JoshSilver8/ENGR454_Buck_Converter/Pictures/buckconvPCB.png

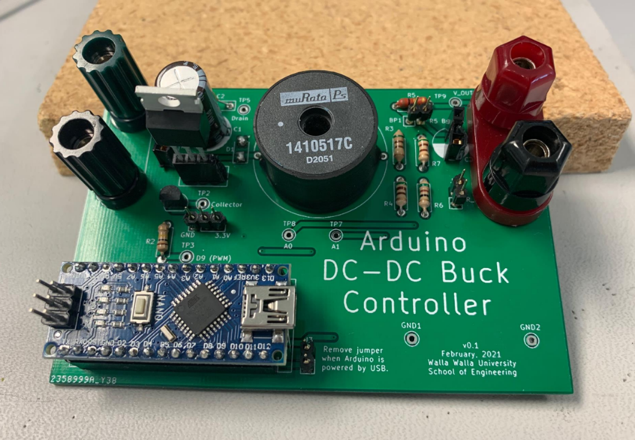
Pictures/buckconvPCB.png
