JoshSilver8/ENGR454_Buck_Converter/Pictures/buckconvPCBback.png

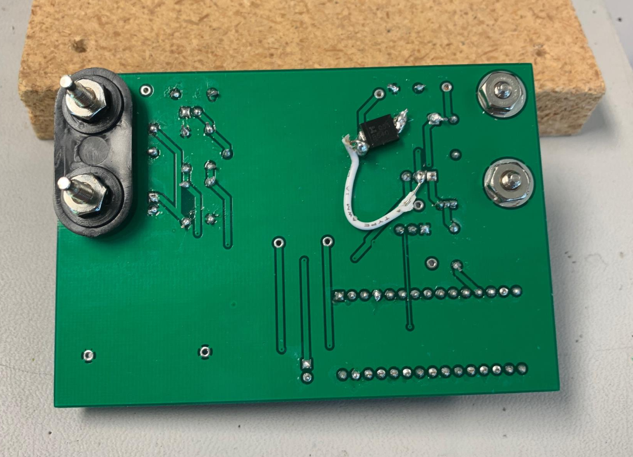
Pictures/buckconvPCBback.png
