JoshSilver8/ENGR454_Buck_Converter/Pictures/BuckConverterTopologyIdeal.png

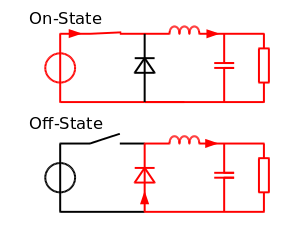
Pictures/BuckConverterTopologyIdeal.png
