JoshSilver8/ENGR454_Buck_Converter/Pictures/DCM_Python.png

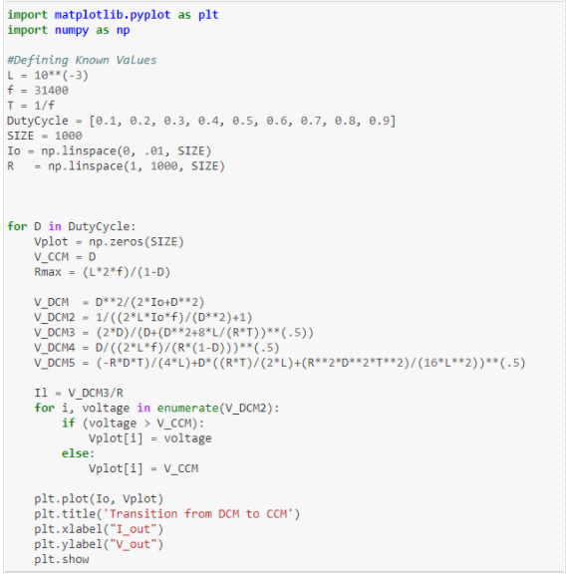
Pictures/DCM_Python.png
