JoshSilver8/ENGR454_Buck_Converter/Pictures/DCM_to_CCM_Graph.png

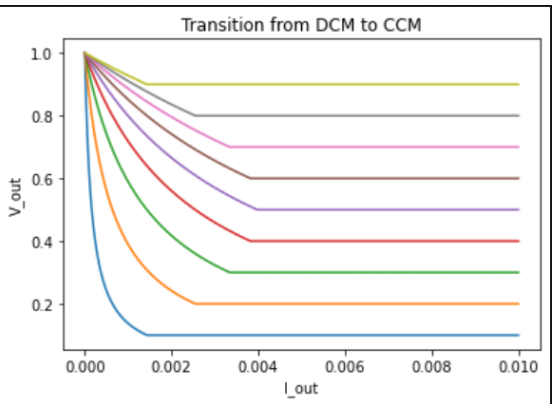
Pictures/DCM_to_CCM_Graph.png
