JoshSilver8/ENGR454_Buck_Converter/Pictures/Feedback_BD.png

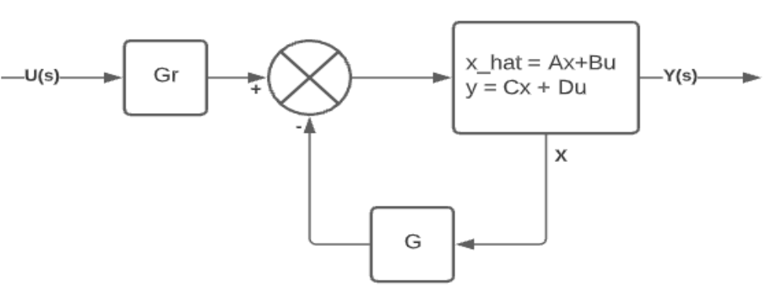
Pictures/Feedback_BD.png
