JoshSilver8/ENGR454_Buck_Converter/Pictures/fullorderobserverarduino.png

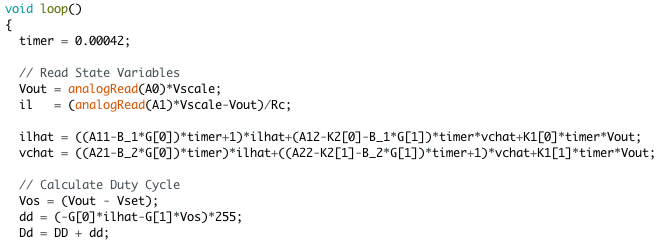
Pictures/fullorderobserverarduino.png
