JoshSilver8/ENGR454_Buck_Converter/Pictures/Fullorderobserverblockdiagram.png

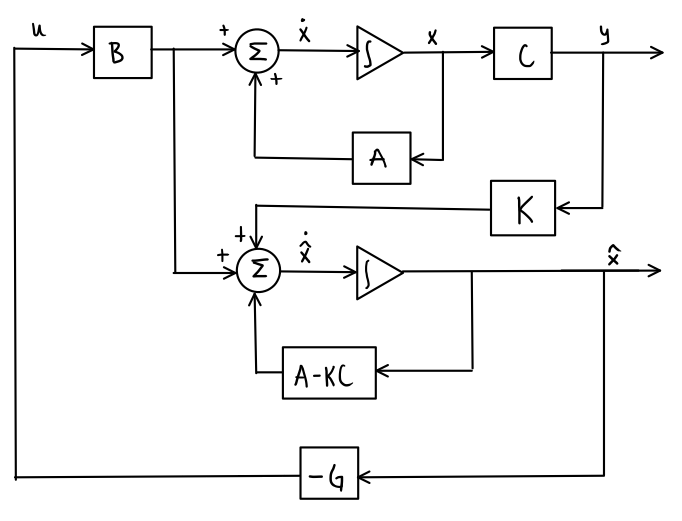
Pictures/Fullorderobserverblockdiagram.png
