JoshSilver8/ENGR454_Buck_Converter/Pictures/fullorderobserverdiscrete1.png

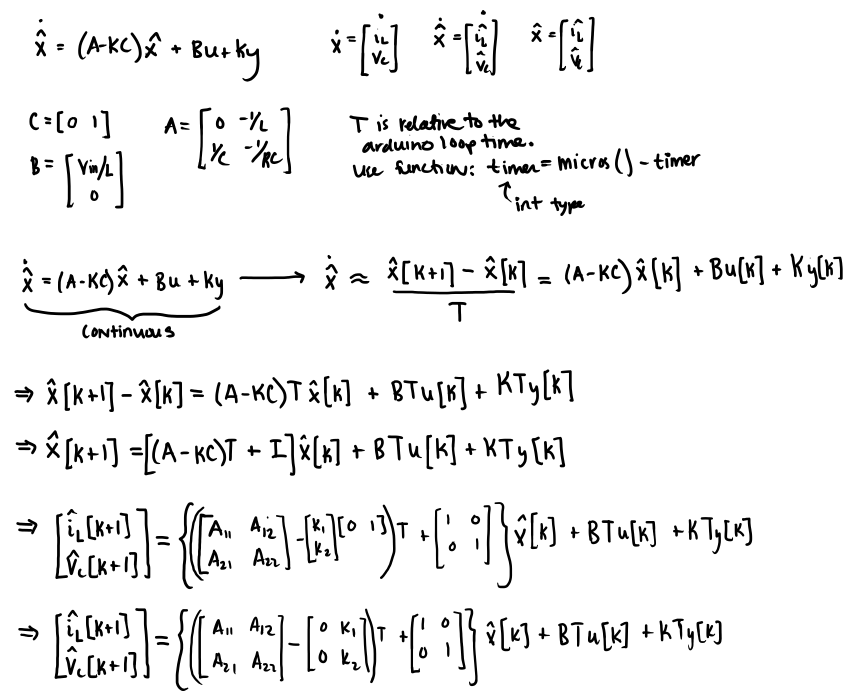
Pictures/fullorderobserverdiscrete1.png
