JoshSilver8/ENGR454_Buck_Converter/Pictures/fullorderobserverdiscrete2.png

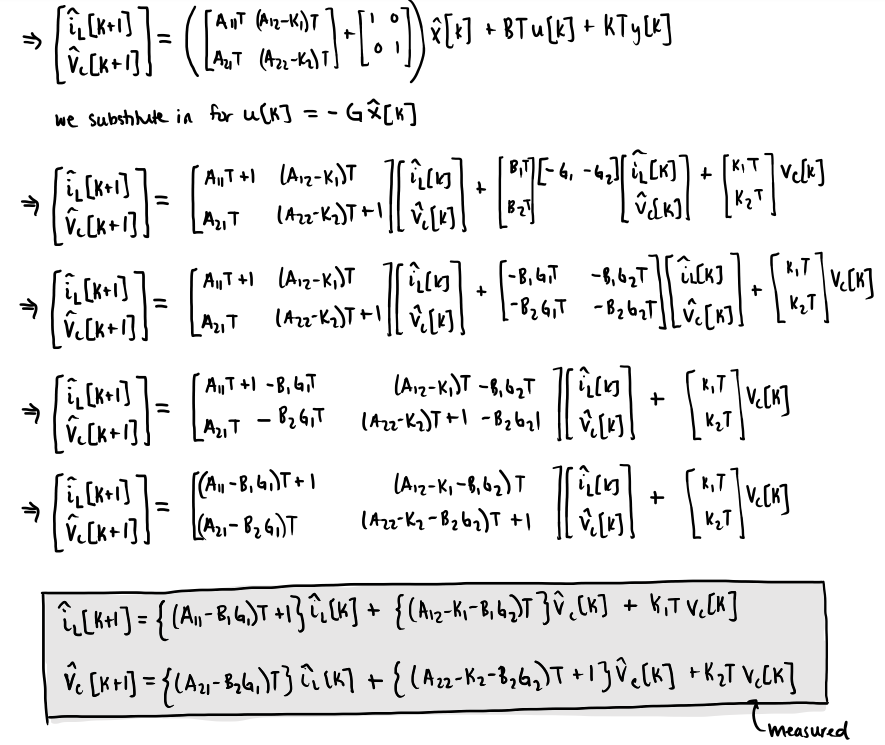
Pictures/fullorderobserverdiscrete2.png
