JoshSilver8/ENGR454_Buck_Converter/Pictures/Fullorderobserveroscilloscope.PNG

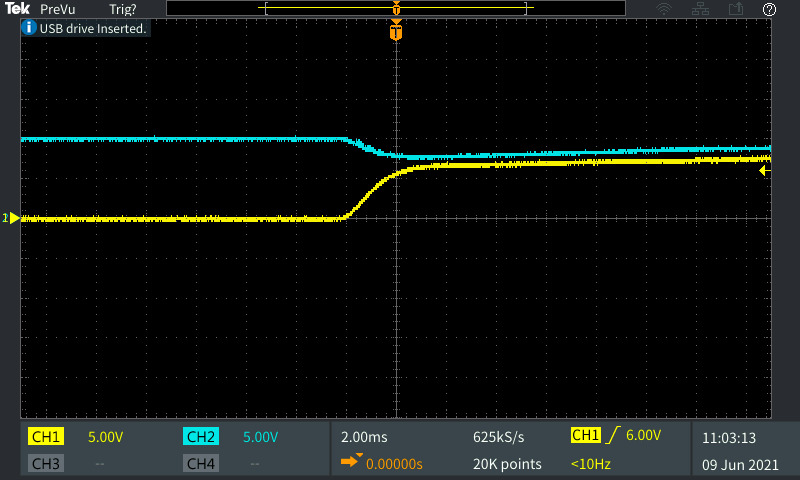
Pictures/Fullorderobserveroscilloscope.PNG
