JoshSilver8/ENGR454_Buck_Converter/Pictures/HPP_eq2.png

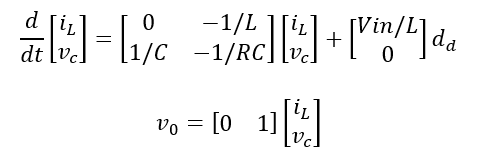
Pictures/HPP_eq2.png
