JoshSilver8/ENGR454_Buck_Converter/Pictures/Pole_Placement_Comp.png

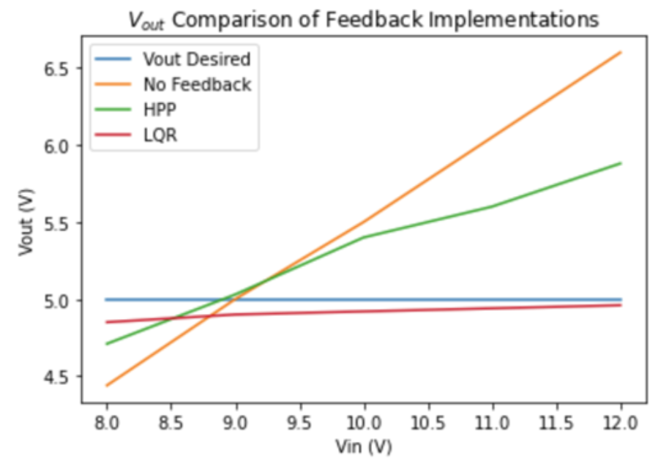
Pictures/Pole_Placement_Comp.png
