JoshSilver8/ENGR454_Buck_Converter/Pictures/reducedorderarduinocode.png

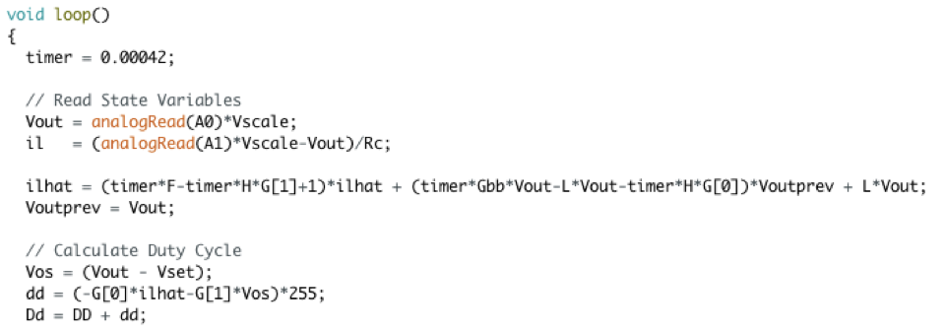
Pictures/reducedorderarduinocode.png
