JoshSilver8/ENGR454_Buck_Converter/Pictures/reducedordercomparison1.png

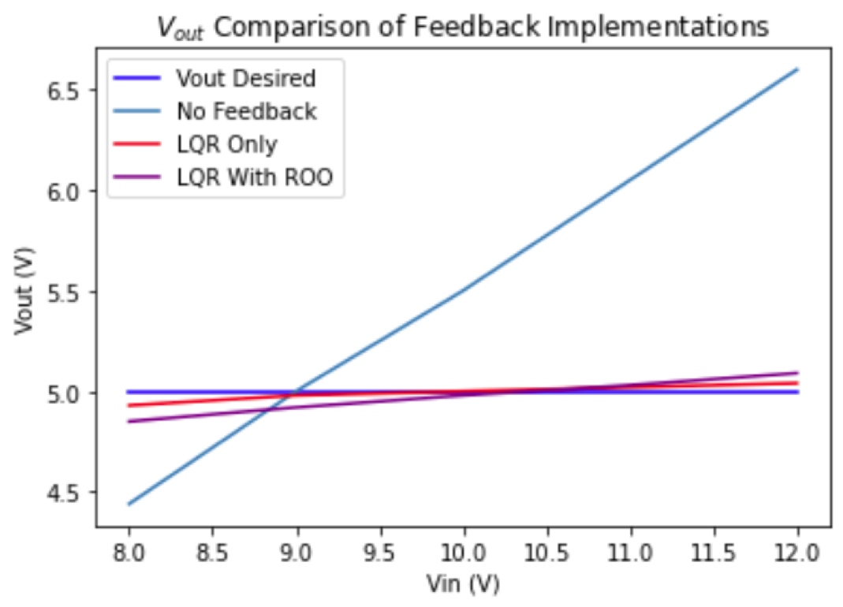
Pictures/reducedordercomparison1.png
