JoshSilver8/ENGR454_Buck_Converter/Pictures/reducedordercomparison2.png

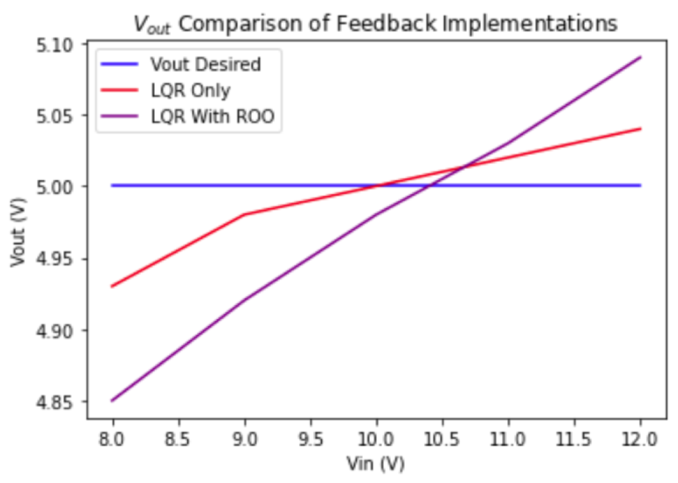
Pictures/reducedordercomparison2.png
