JoshSilver8/ENGR454_Buck_Converter/Pictures/reducedorderdiscretetime.png

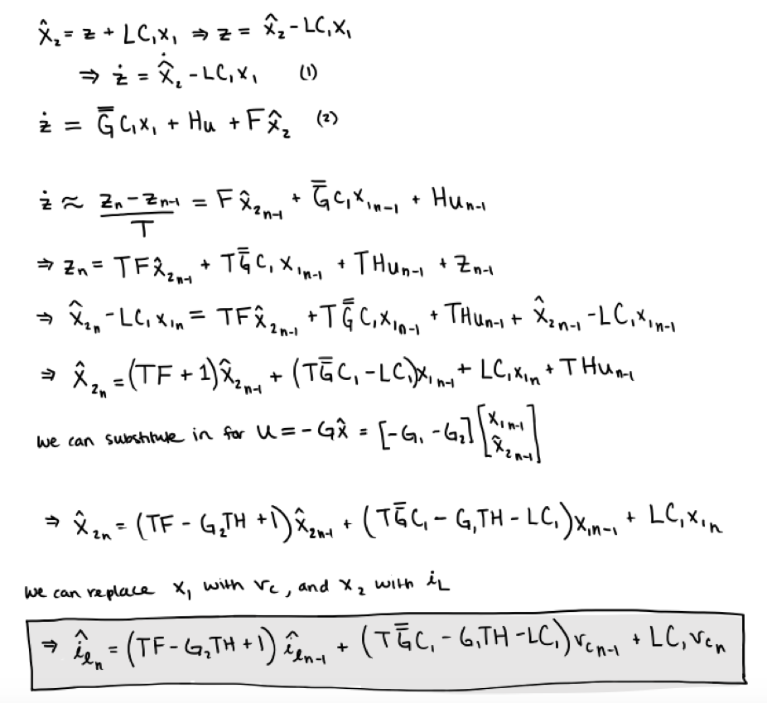
Pictures/reducedorderdiscretetime.png
