JoshSilver8/ENGR454_Buck_Converter/Pictures/reducedorderequations.png

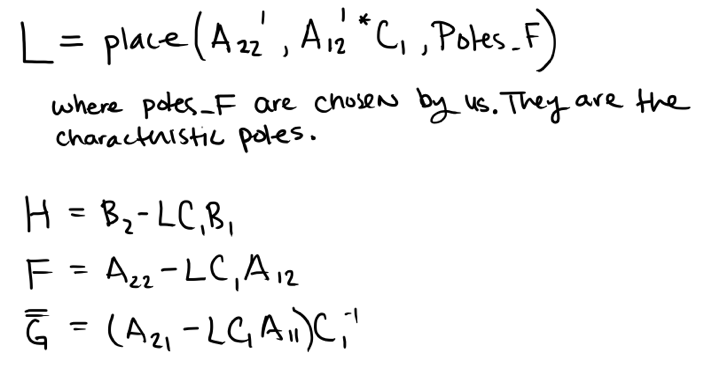
Pictures/reducedorderequations.png
