JoshSilver8/ENGR454_Buck_Converter/Pictures/reducedorderfeedbackvalues.png

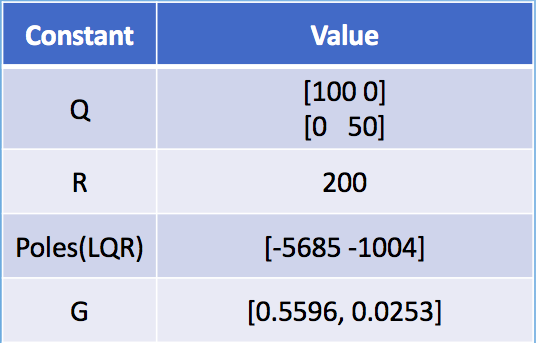
Pictures/reducedorderfeedbackvalues.png
