JoshSilver8/ENGR454_Buck_Converter/Pictures/reducedordermatlaberror.png

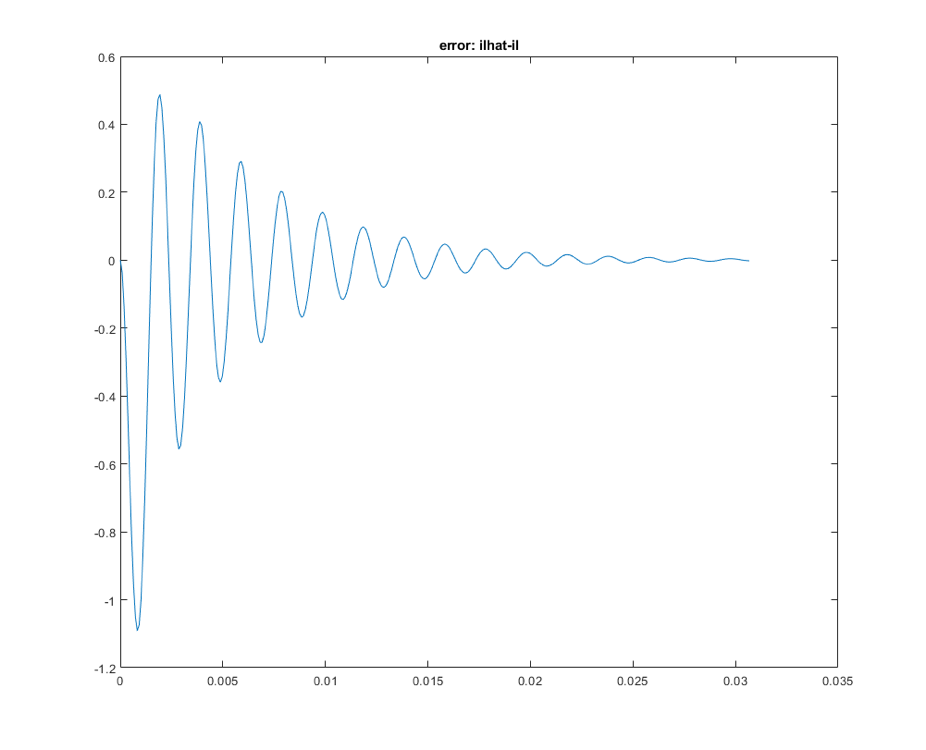
Pictures/reducedordermatlaberror.png
