JoshSilver8/ENGR454_Buck_Converter/Pictures/reducedordermatlabfeedback.png

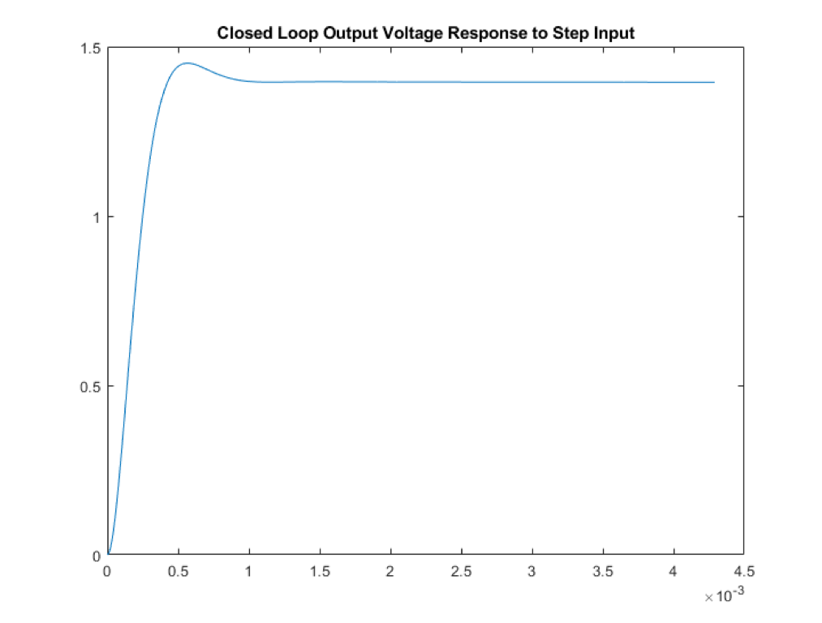
Pictures/reducedordermatlabfeedback.png
