JoshSilver8/ENGR454_Buck_Converter/Pictures/reducedordermatrix.png

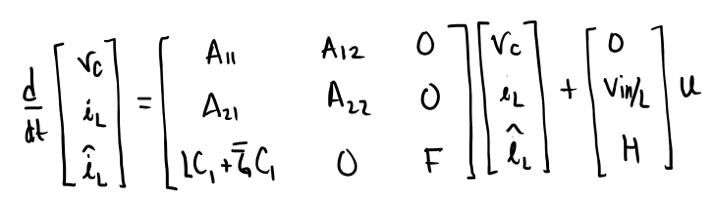
Pictures/reducedordermatrix.png
