JoshSilver8/ENGR454_Buck_Converter/Pictures/reducedorderoscilloscope.png

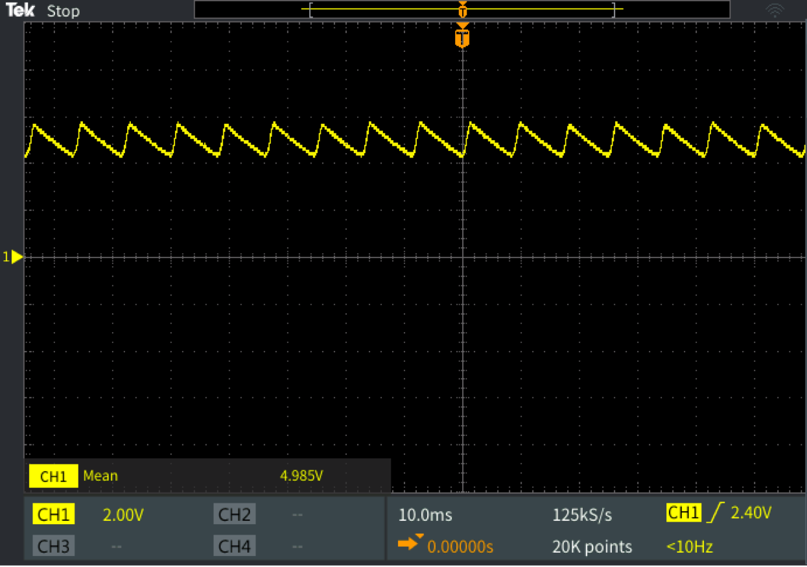
Pictures/reducedorderoscilloscope.png
