JoshSilver8/ENGR454_Buck_Converter/Pictures/reducedordervariablevalules.png

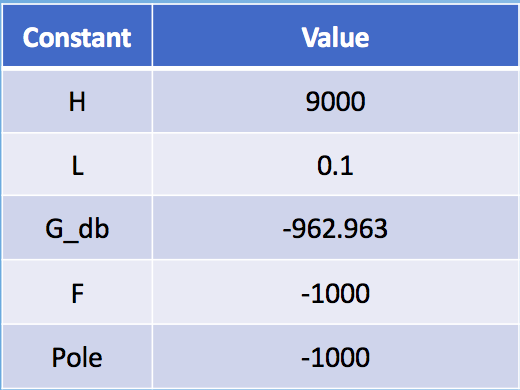
Pictures/reducedordervariablevalules.png
