JoshSilver8/ENGR454_Buck_Converter/Pictures/statespacemodeling1.png

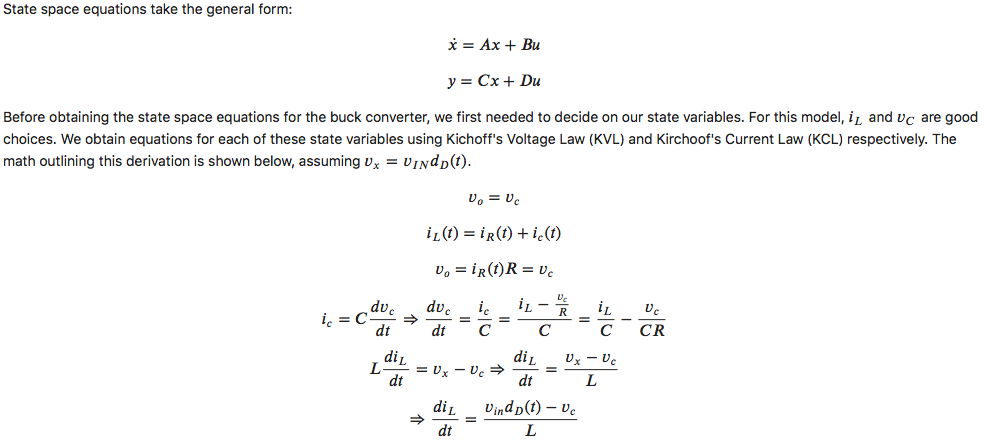
Pictures/statespacemodeling1.png
