JoshSilver8/ENGR454_Buck_Converter/Pictures/statespacemodeling2.png

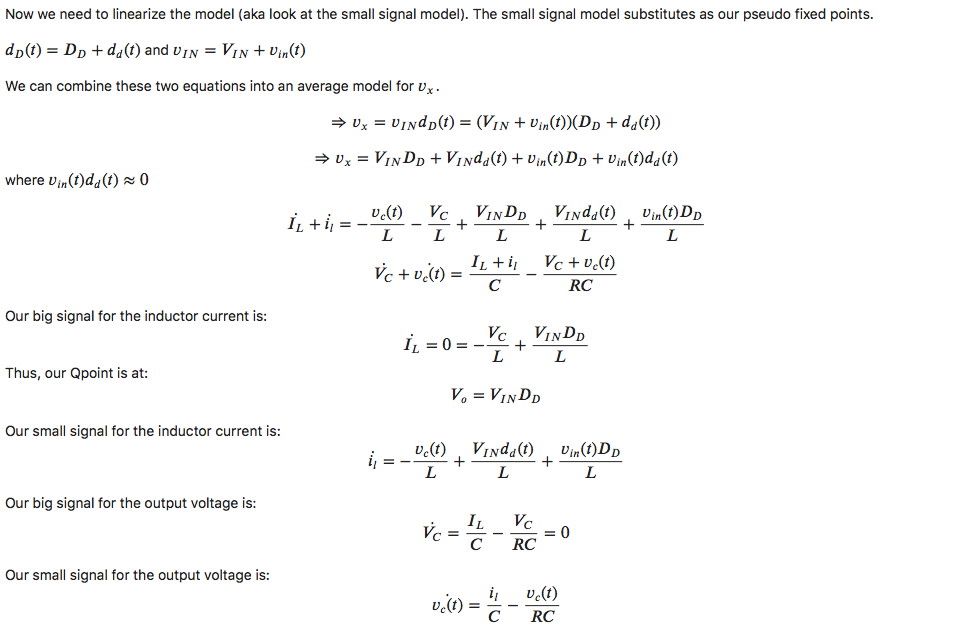
Pictures/statespacemodeling2.png
