JoshSilver8/ENGR454_Buck_Converter/Pictures/statespacemodeling3.png

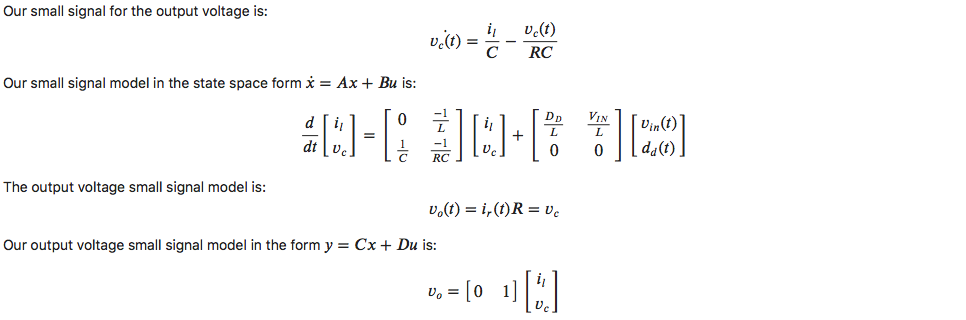
Pictures/statespacemodeling3.png
