JoshSilver8/ENGR454_Buck_Converter/Pictures/reducedOrderblockdiagram.png

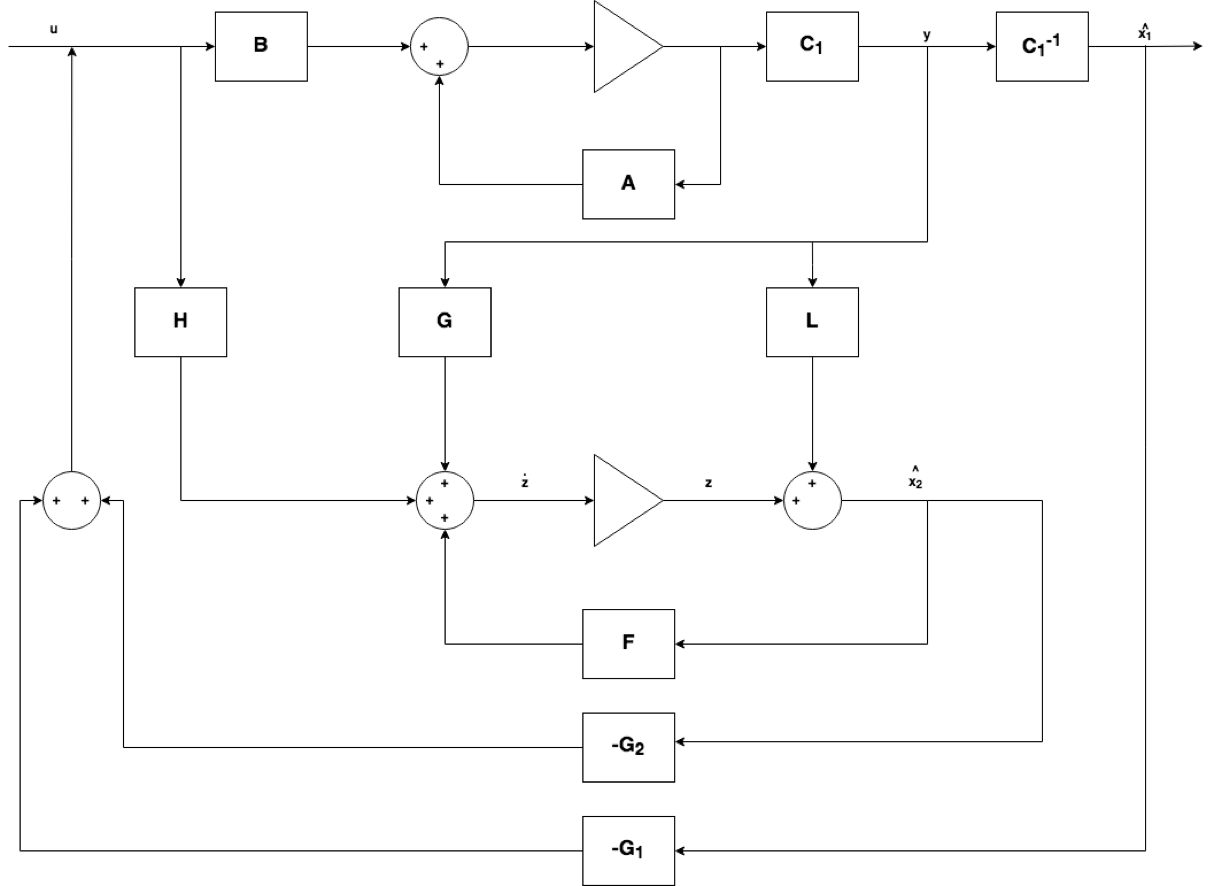
Pictures/reducedOrderblockdiagram.png
