JoshSilver8/ENGR454_Buck_Converter/Pictures/BuckConverterSchematic.pdf

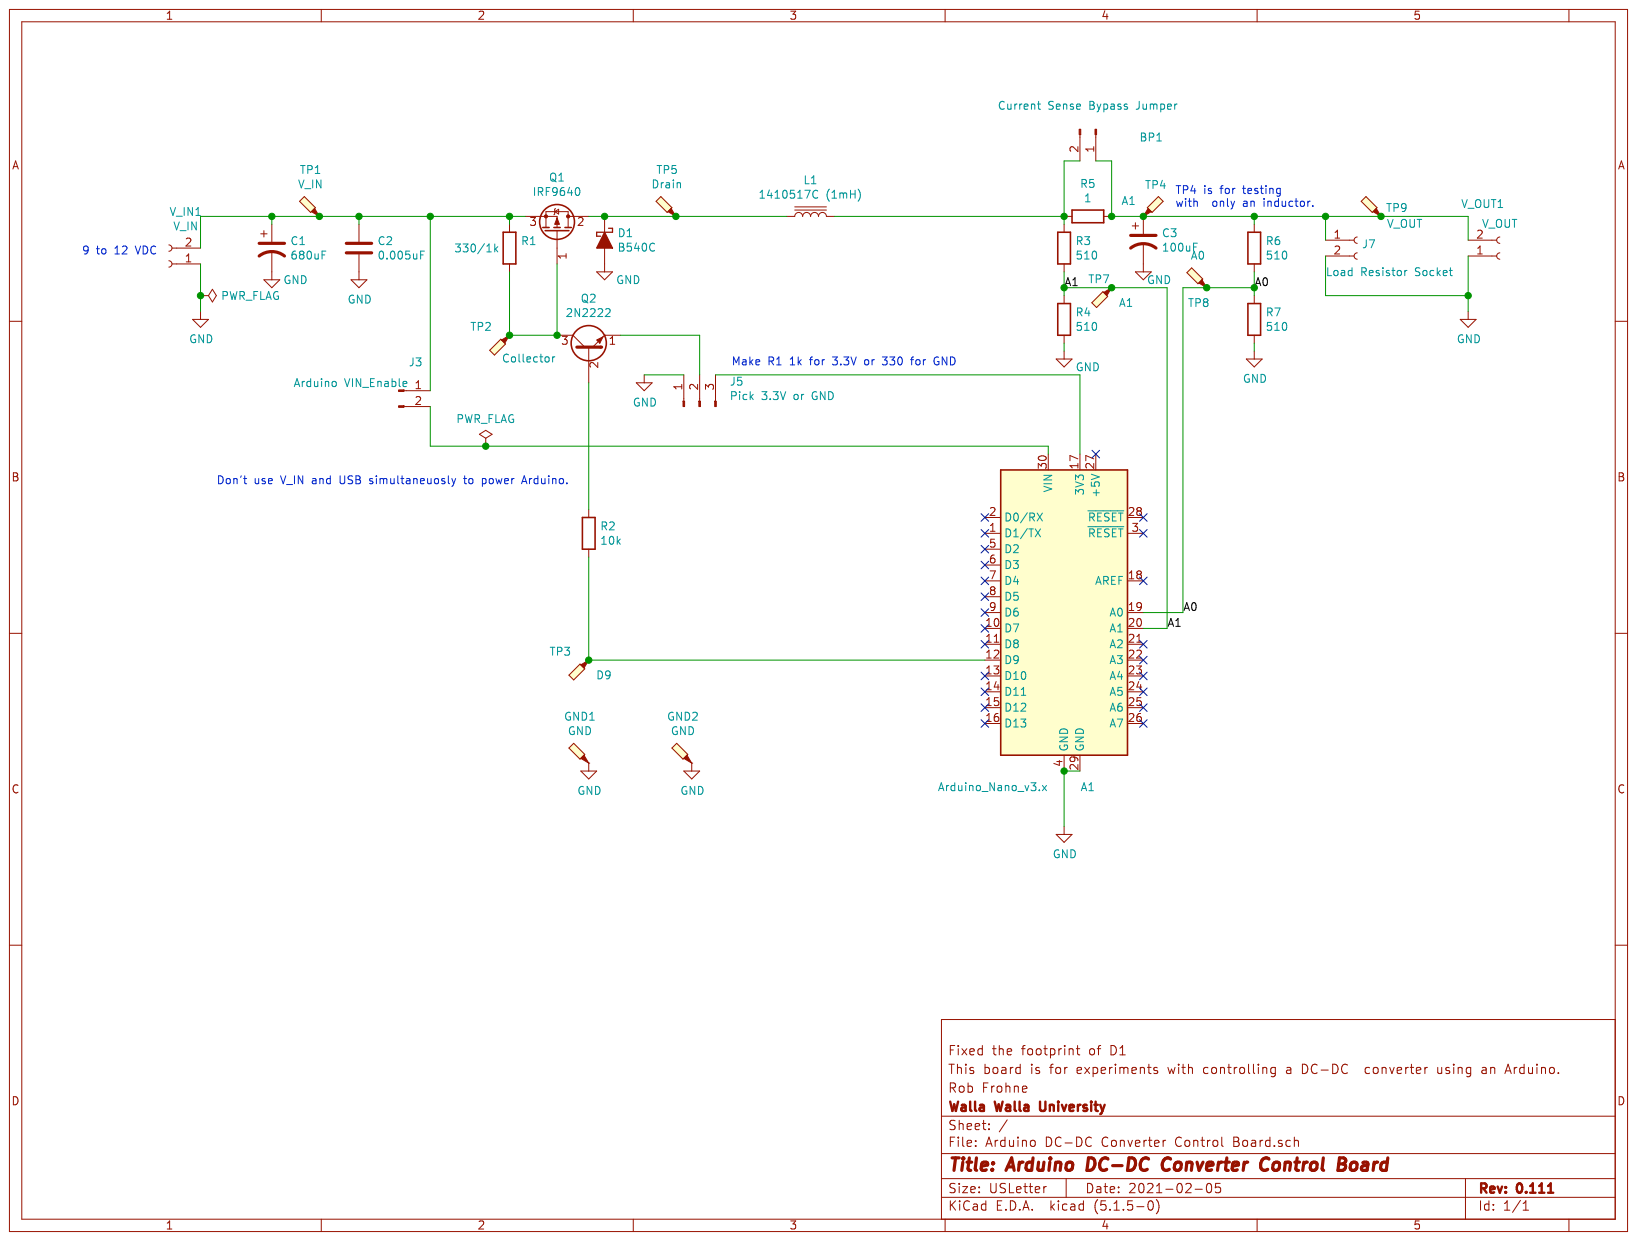
[picture p29: page 1]
