JoshSilver8/ENGR454_Buck_Converter/LTspiceModels/ArduinoBuckConverterLtspice.asc

C1: cap; 100µ; Rser=.1
D1: schottky; B540C
L1: ind; 1mH; Rser=.1
Q1: pmos; IRF9640
Q2: npn; 2N2222
R1: res; 345
R2: res; 10.47k
R3: res; 8m
R5: res; 1
Rinductor: res; {Rinductor}
RL: res; 27
V1: voltage; 10V
V2: voltage; PULSE(0 4.5 0 {T/100} {T/100} {.5*T} {T})
V3: voltage; 3.3
Named nets: 0
.param T={1/31400}
.tran {400*T}
R2 needs to be at least one watt.
D1 should be at least 1/2 watt.
R3 needs to be 1/4 watt at least.
Q1 must dissipate at least 500 mW.
.step param Rinductor list 0.00001 0.33 0.417
