JoshSilver8/ENGR454_Buck_Converter/ArduinoBuckConverterControl-main/Arduino DC-DC Converter Control Board.kicad_pcb

## KiCad design ArduinoBuckConverterControl-main/Arduino DC-DC Converter Control Board.kicad_pcb (2021-06-05)

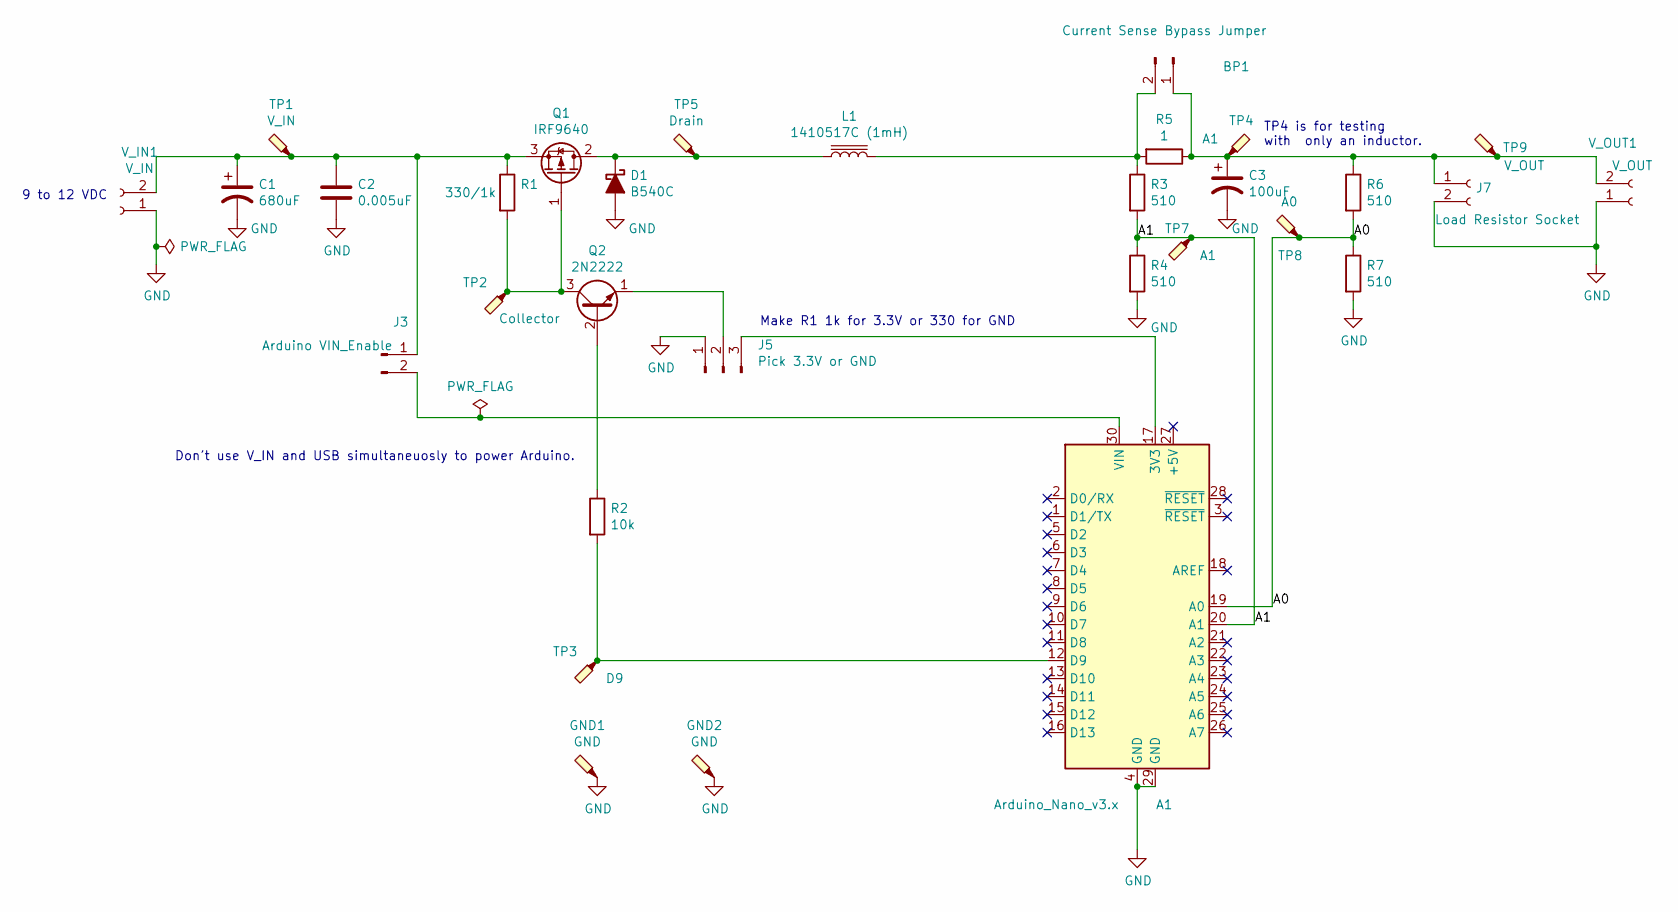
[picture p30: schematic Arduino DC-DC Converter Control Board.sch, Arduino DC-DC Converter Control Board]

Parts:
A1: Arduino_Nano_v3.x; Arduino_Nano
BP1: Current Sense Bypass Jumper; PinHeader_1x02_P2.54mm_Vertical
C1: 680uF; CP_Radial_D10.0mm_P7.50mm
C2: 0.005uF; C_Rect_L7.2mm_W2.5mm_P5.00mm_FKS2_FKP2_MKS2_MKP2
C3: 100uF; CP_Radial_D8.0mm_P5.00mm
D1: B540C; D_3220_8050Metric
GND1, GND2: GND; TestPoint_Keystone_5000-5004_Miniature
J3: Arduino VIN_Enable; PinHeader_1x02_P2.54mm_Vertical
J5: Pick 3.3V or GND; PinHeader_1x03_P2.54mm_Vertical
J7: Load Resistor Socket; PinSocket_1x02_P2.54mm_Vertical
L1: 1410517C (1mH); L_Radial_D29.8mm_P28.30mm_muRATA_1400series
Q1: IRF9640; TO-220F-3_Vertical
Q2: 2N2222; TO-92L_Inline
R1: 330/1k; R_Axial_DIN0207_L6.3mm_D2.5mm_P7.62mm_Horizontal
R2: 10k; R_Axial_DIN0207_L6.3mm_D2.5mm_P7.62mm_Horizontal
R3, R4, R6, R7: 510; R_Axial_DIN0207_L6.3mm_D2.5mm_P7.62mm_Horizontal
R5: 1; R_Axial_DIN0207_L6.3mm_D2.5mm_P7.62mm_Horizontal
TP1: V_IN; TestPoint_Keystone_5000-5004_Miniature
TP2: Collector; TestPoint_Keystone_5000-5004_Miniature
TP3: D9; TestPoint_Keystone_5000-5004_Miniature
TP4: A1; TestPoint_Pad_D4.0mm
TP5: Drain; TestPoint_Keystone_5000-5004_Miniature
TP7: A1; TestPoint_Keystone_5000-5004_Miniature
TP8: A0; TestPoint_Keystone_5000-5004_Miniature
TP9: V_OUT; TestPoint_Keystone_5000-5004_Miniature
V_IN1: V_IN; Banana_Jack_2Pin
V_OUT1: V_OUT; Banana_Jack_2Pin

Connections:
/A0: A1.19 (A0), R6.2, R7.1, TP8.1
/A1: A1.20 (A1), R3.2, R4.1, TP7.1
GND: A1.4 (GND), A1.29 (GND), C1.2, C2.2, C3.2, D1.2 (A), GND1.1, GND2.1, J5.1, J7.2, R4.2, R7.2, V_IN1.1, V_OUT1.1
unnamed: A1.12 (D9), R2.2, TP3.1
unnamed: A1.17 (3V3), J5.3
unnamed: A1.30 (VIN), J3.2
unnamed: BP1.1, C3.1, J7.1, R5.1, R6.1, TP4.1, TP9.1, V_OUT1.2
unnamed: BP1.2, L1.2, R3.1, R5.2
unnamed: C1.1, C2.1, J3.1, Q1.3 (S), R1.1, TP1.1, V_IN1.2
unnamed: D1.1 (K), L1.1, Q1.2 (D), TP5.1
unnamed: J5.2, Q2.1 (E)
unnamed: Q1.1 (G), Q2.3 (C), R1.2, TP2.1
unnamed: Q2.2 (B), R2.1

Notes on the sheet:
9 to 12 VDC
Don't use V_IN and USB simultaneuosly to power Arduino.
Make R1 1k for 3.3V or 330 for GND
TP4 is for testing with only an inductor.

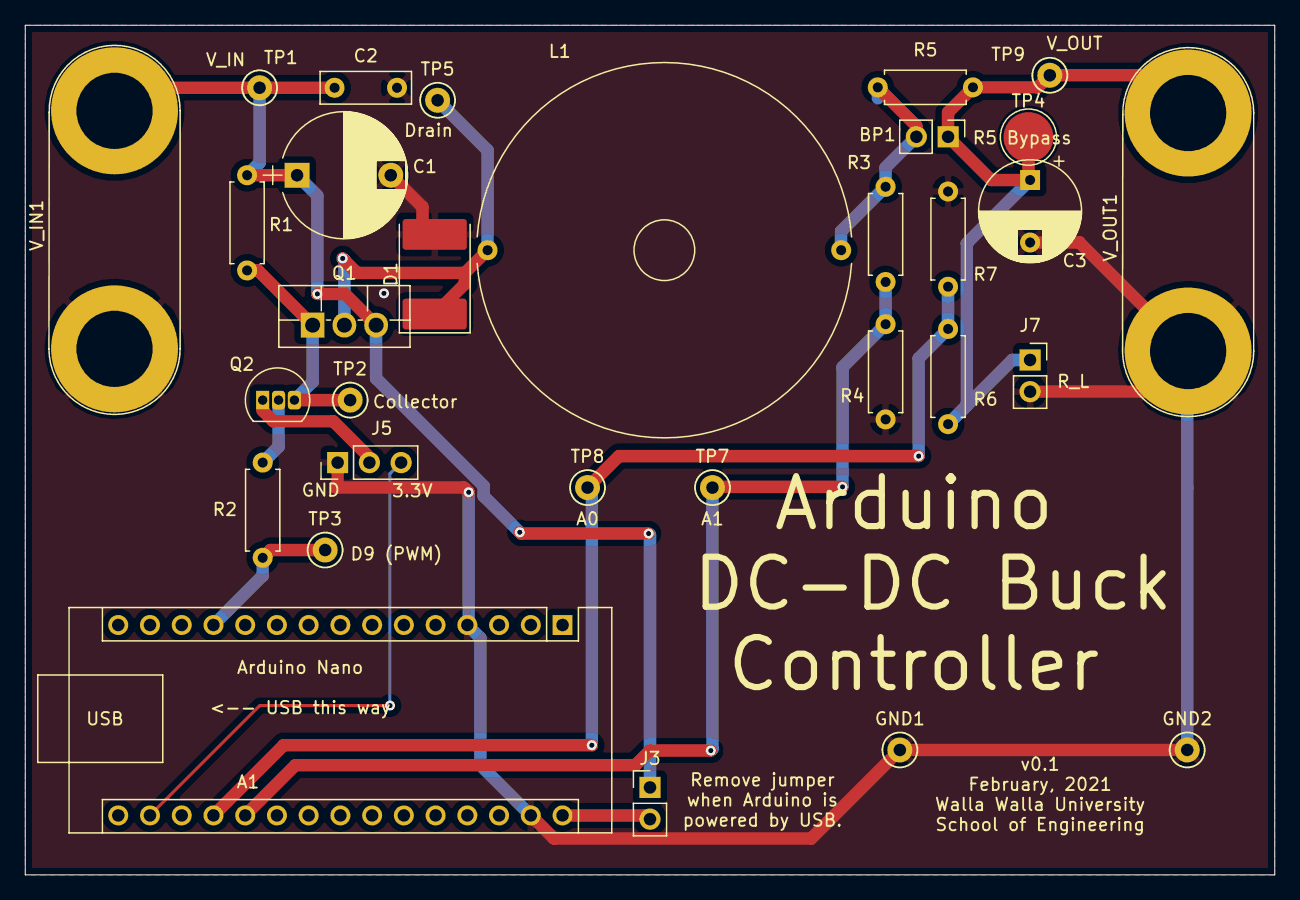
[picture p31: board Arduino DC-DC Converter Control Board.kicad_pcb from above]

Board: 2 copper layers, 100.0 x 68.0 mm, 31 parts (0 on the bottom side), 13 nets.
