JoshSilver8/ENGR454_Buck_Converter/Pictures/Step_Response_HPP.png

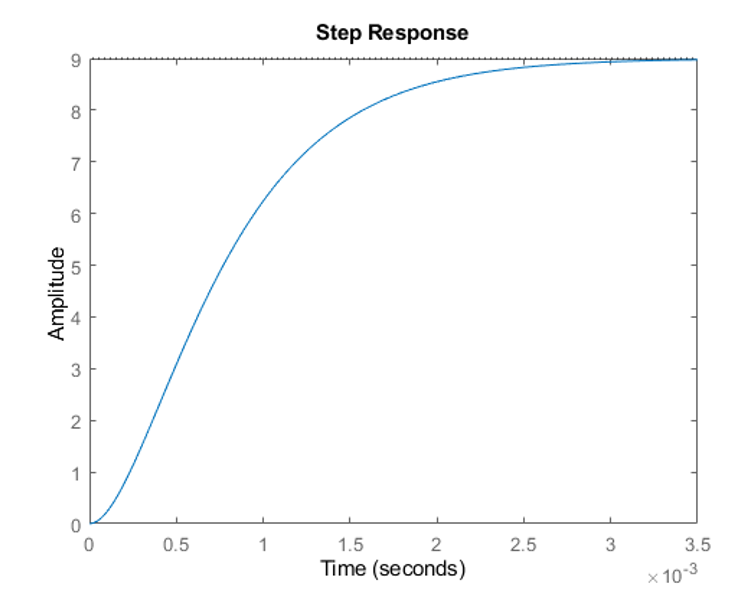
Pictures/Step_Response_HPP.png
