JoshSilver8/ENGR454_Buck_Converter/Pictures/Step_Response_LQR.png

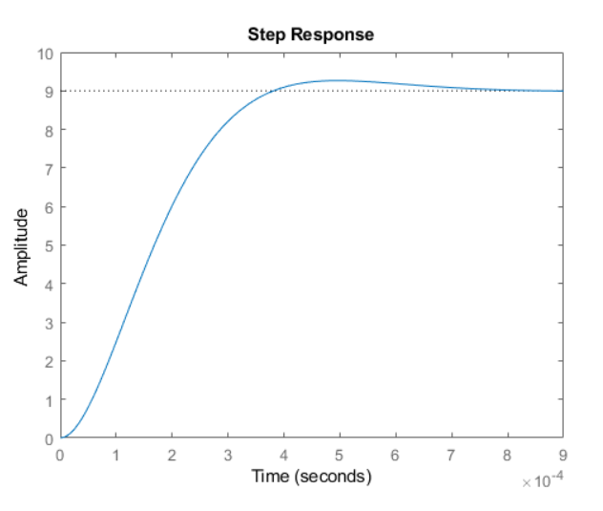
Pictures/Step_Response_LQR.png
