JoshSilver8/ENGR454_Buck_Converter/Pictures/Step_Response_No_Feedback.png

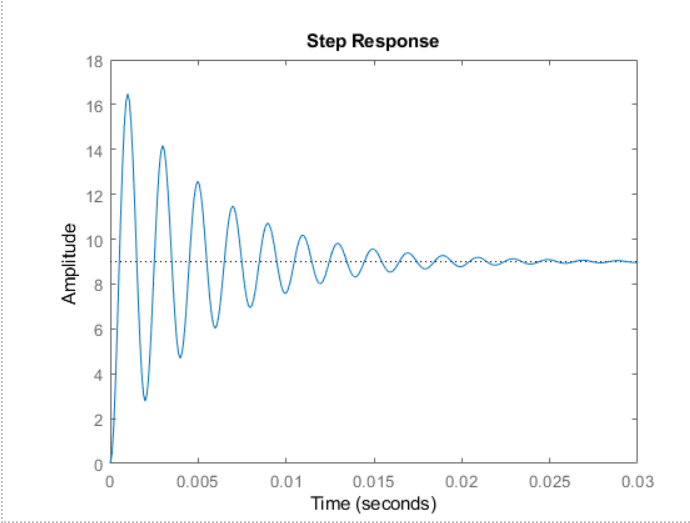
Pictures/Step_Response_No_Feedback.png
