JoshSilver8/ENGR454_Buck_Converter/(commit log)

2021-06-05 Adding Frohne KiCad Files
    [Arduino DC-DC Converter Control Board.kicad_pcb, Arduino DC-DC Converter Control Board.sch]
2021-06-09 Full Order Observer folder and arduino files
2021-06-09 adding reduced order observer arduino file
2021-06-09 adding hand placing poles arduino file
2021-06-09 adding LQR arduino file
2021-06-09 adding arduino test files and ltspice models
2021-06-09 adding kalman filter arduino file
